Arushi-isha/EMG-Based-Prosthetic-Hand-using-Neural-Networks/Pros3.jpeg

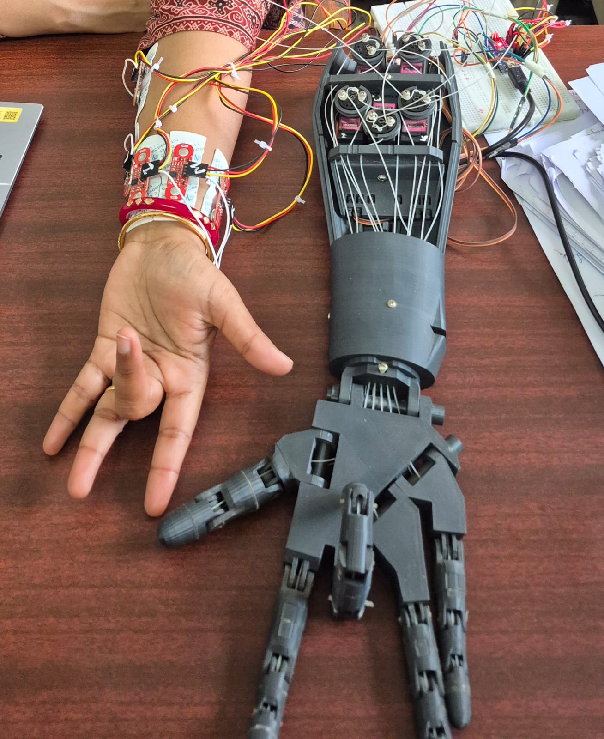
Pros3.jpeg
