Arushi-isha/EMG-Based-Prosthetic-Hand-using-Neural-Networks/Pros2.jpeg

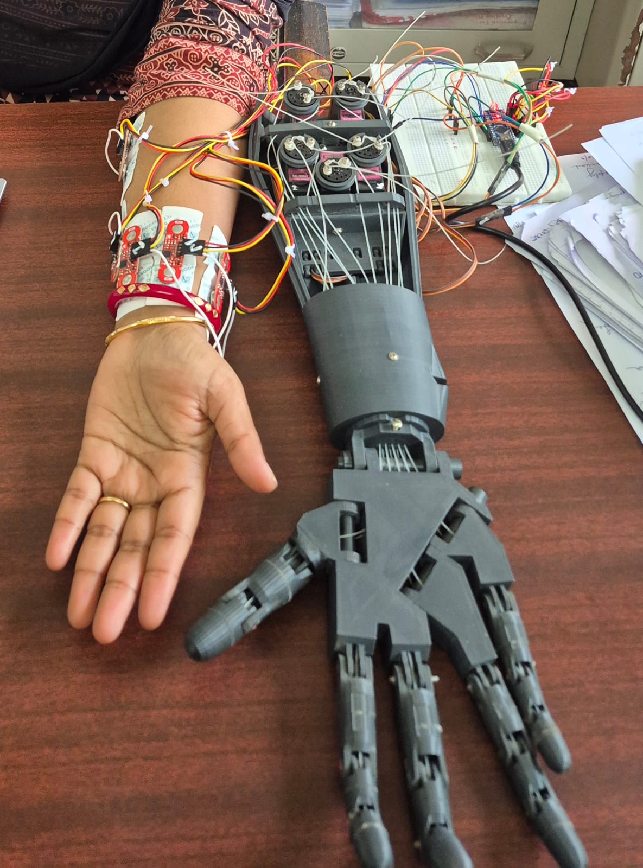
Pros2.jpeg
