Arushi-isha/EMG-Based-Prosthetic-Hand-using-Neural-Networks/Block Diagram.png

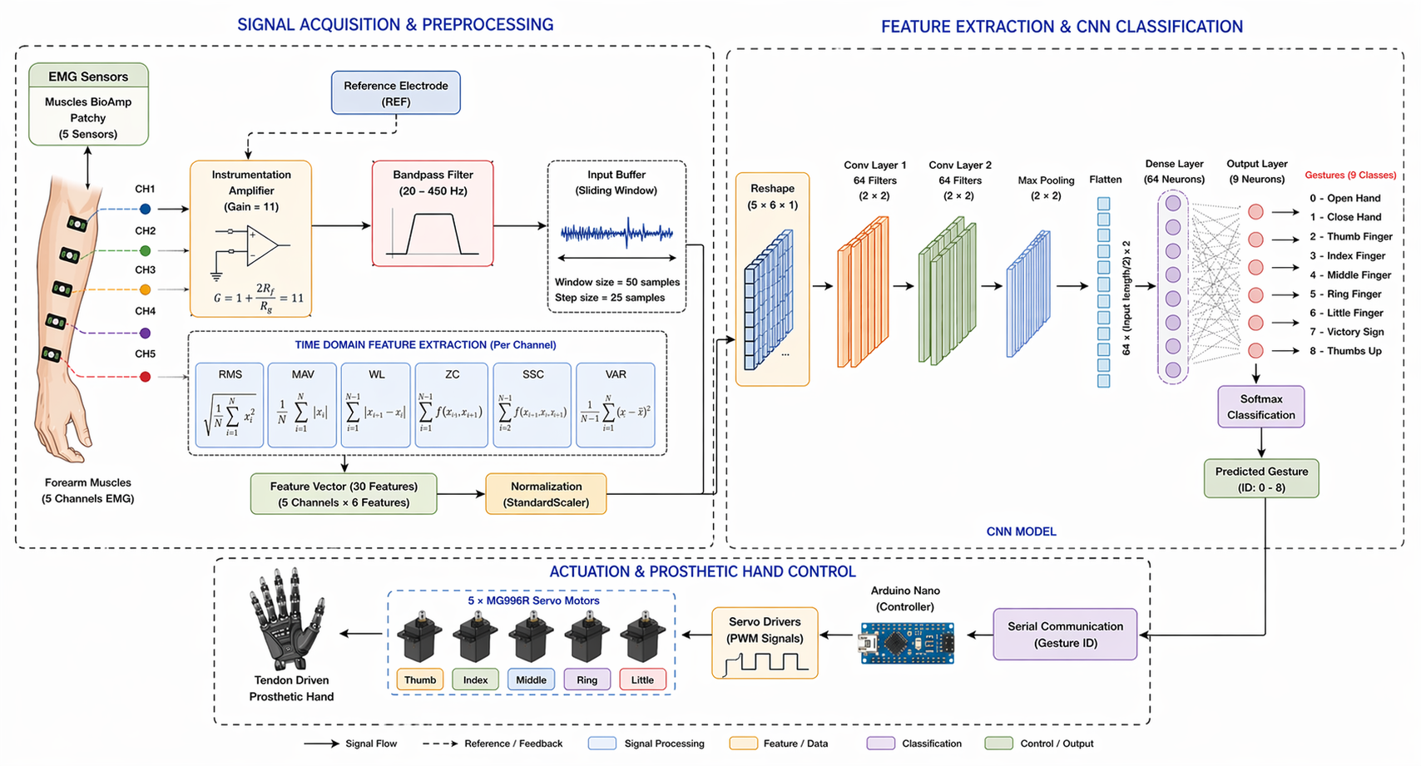
Block Diagram.png
