Arushi-isha/EMG-Based-Prosthetic-Hand-using-Neural-Networks/CNN Architecture.png

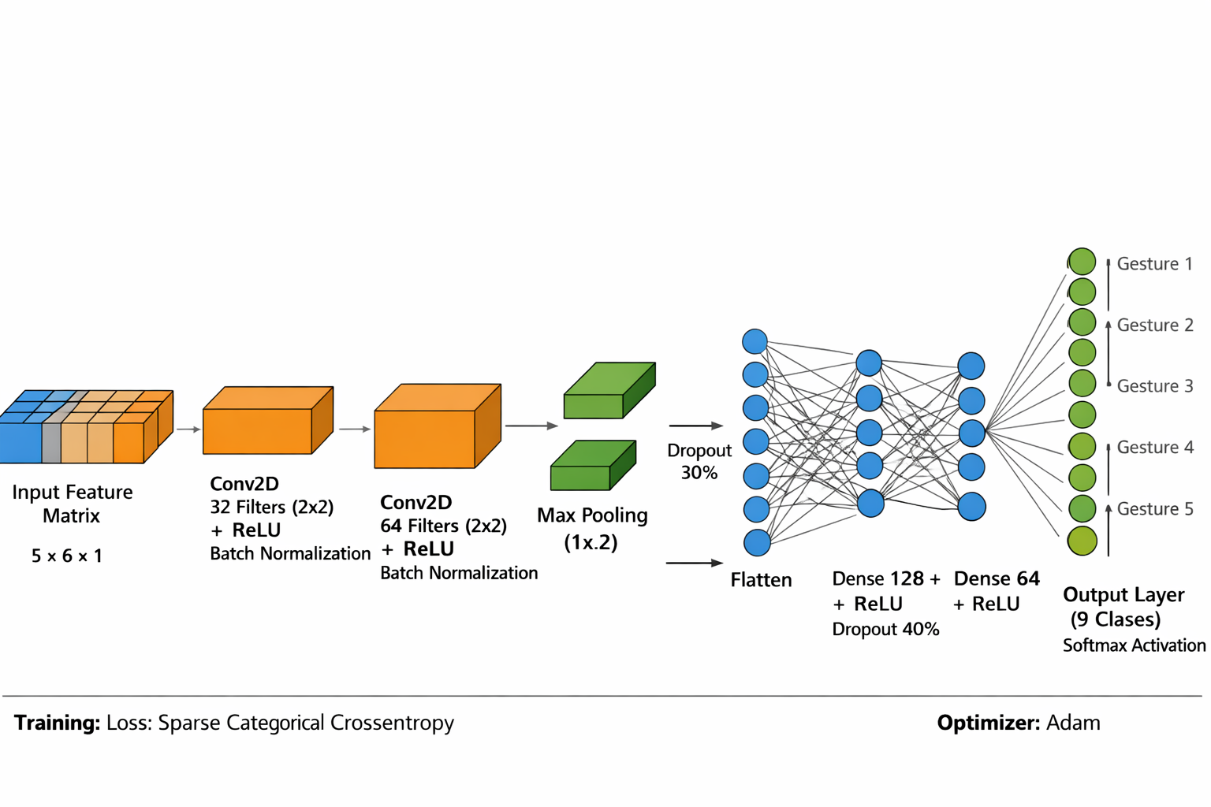
CNN Architecture.png
