Arushi-isha/EMG-Based-Prosthetic-Hand-using-Neural-Networks/confusion.png

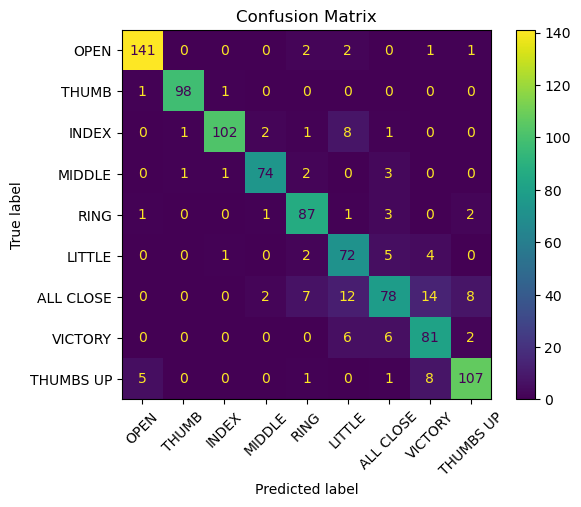
confusion.png
