Arushi-isha/EMG-Based-Prosthetic-Hand-using-Neural-Networks/Pros1.jpeg

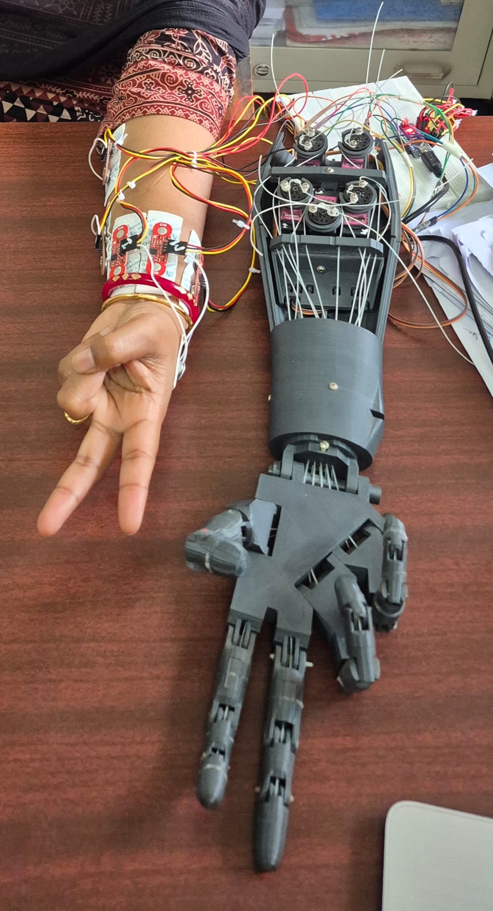
Pros1.jpeg
