Arushi-isha/EMG-Based-Prosthetic-Hand-using-Neural-Networks/roc.png

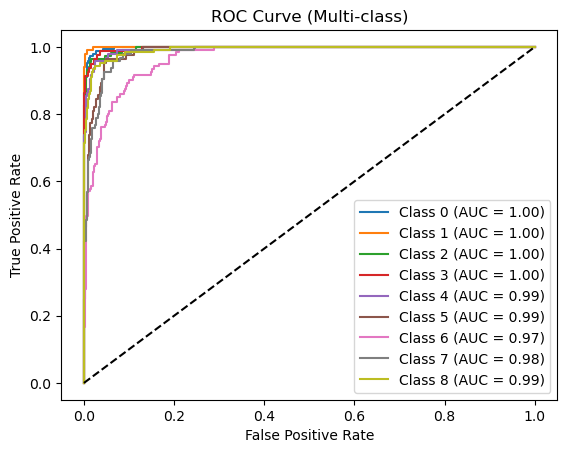
roc.png
